mattbrejza/ukhas14-badge/board/graphics/bare.png

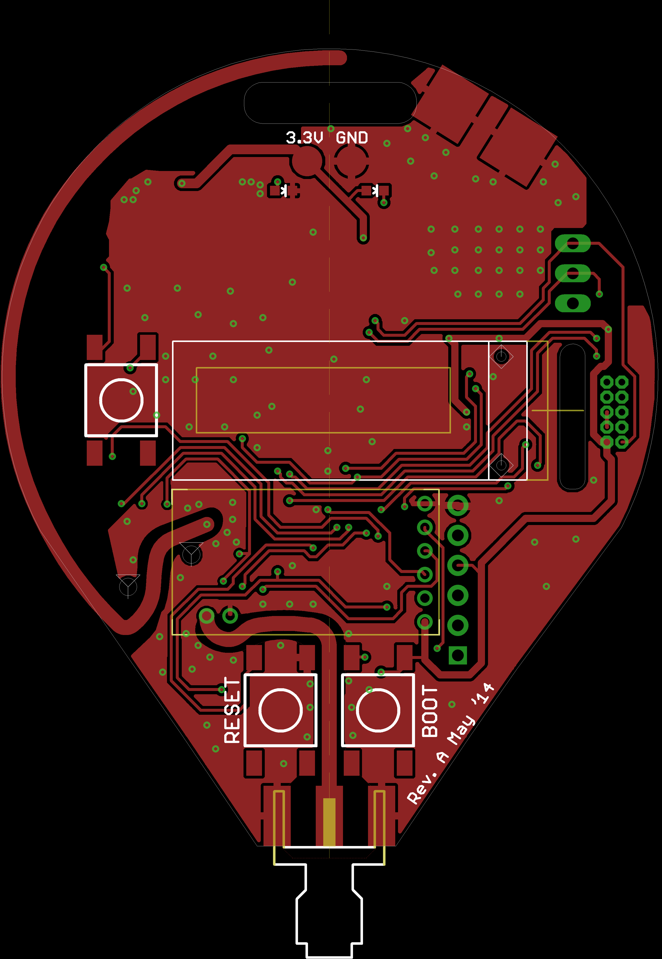
board/graphics/bare.png
