mattbrejza/ukhas14-badge/board/graphics/barepadssilk.png

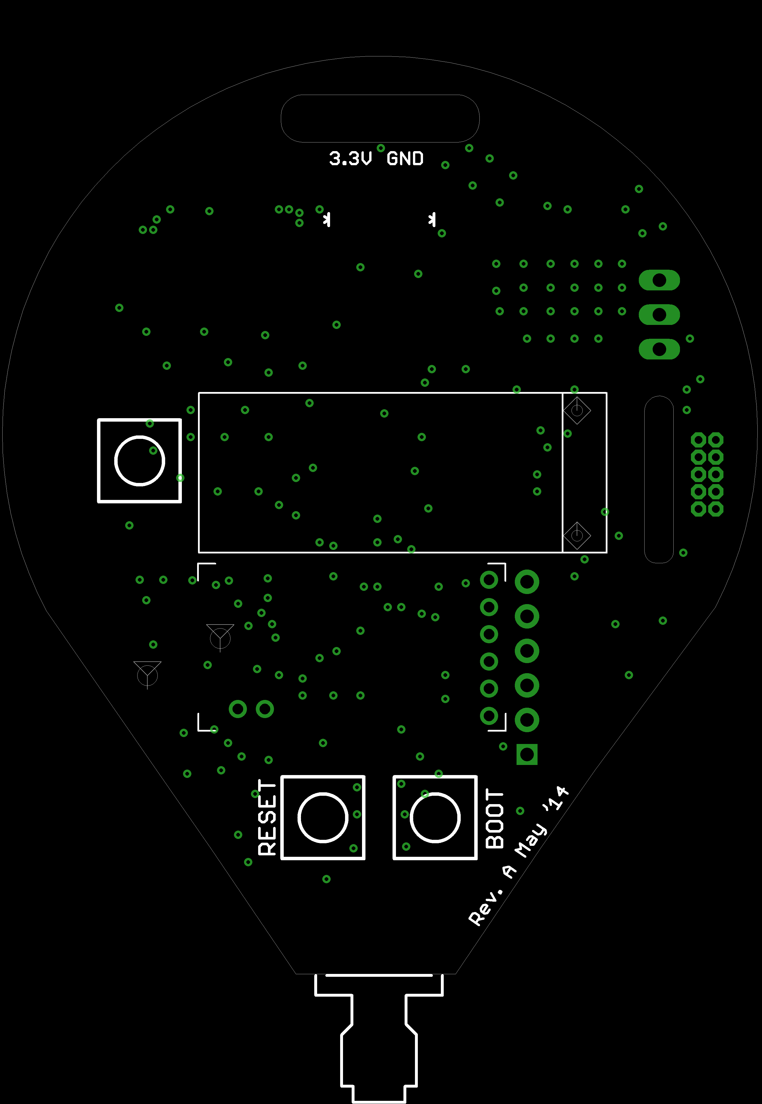
board/graphics/barepadssilk.png
