mattbrejza/ukhas14-badge/board/badge.brd

## EAGLE design board/badge.brd (2014-07-02)

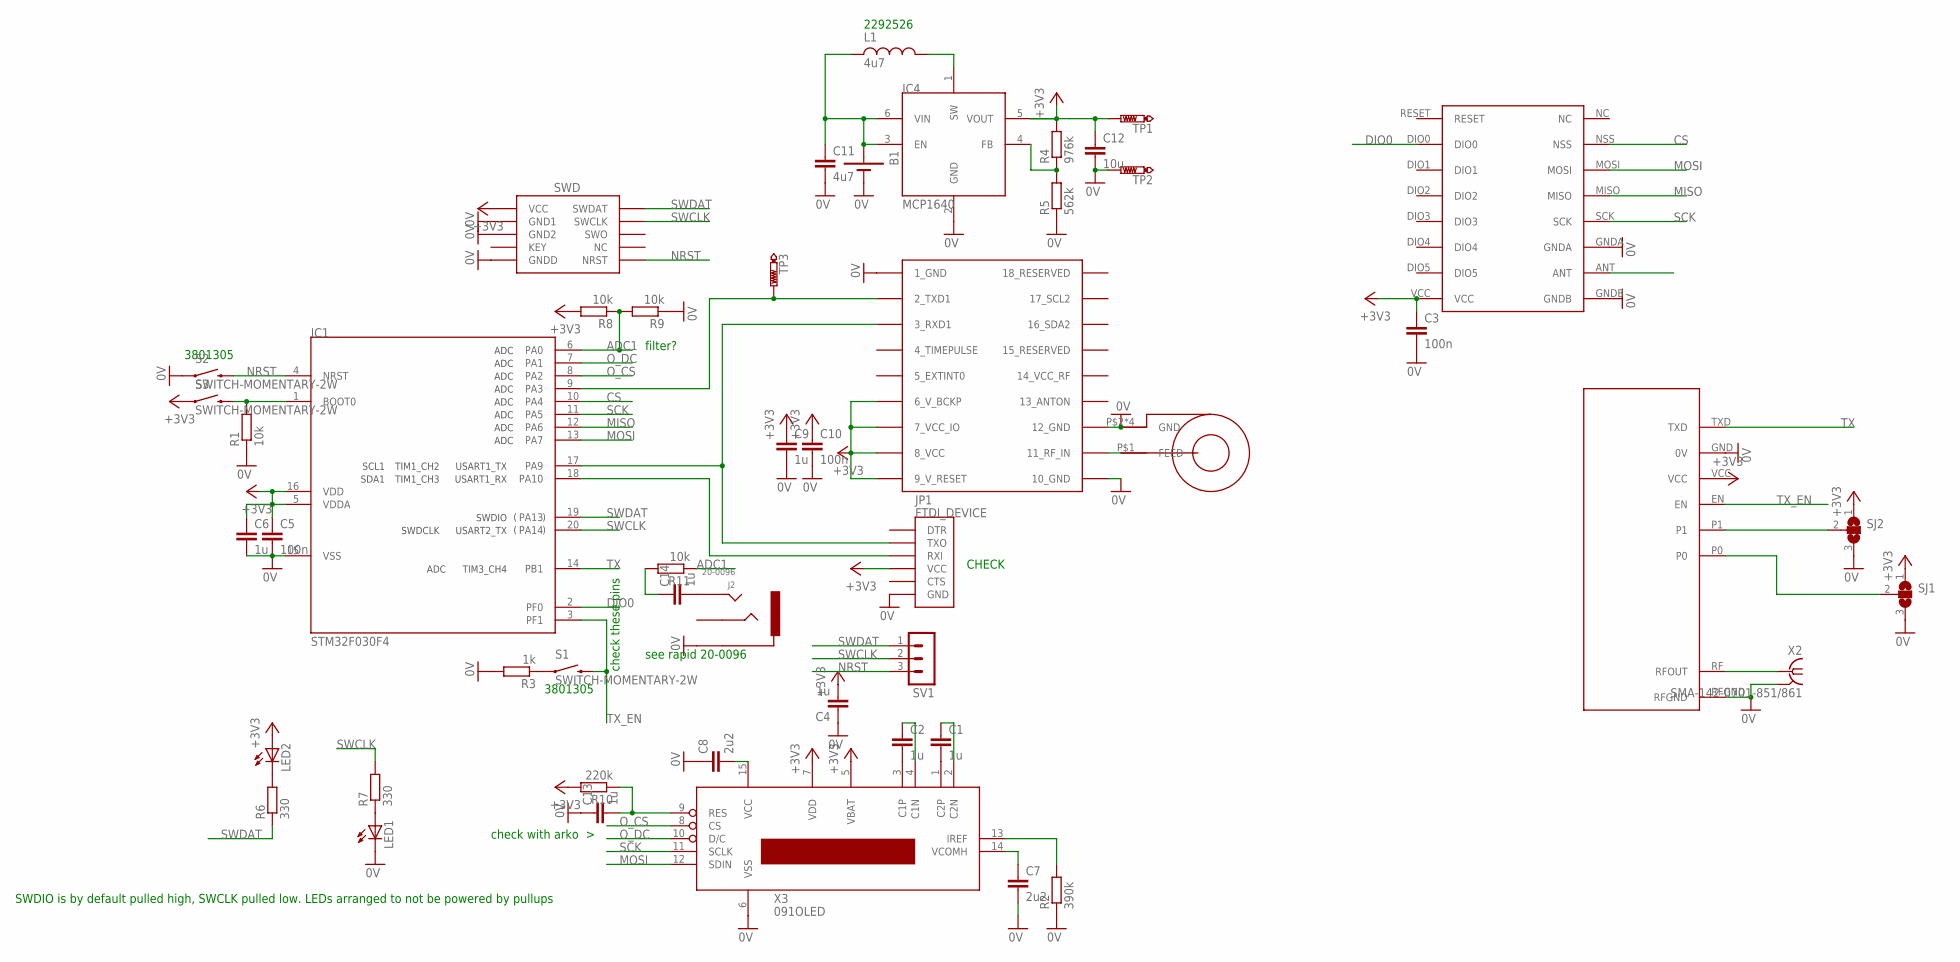
[picture p3: schematic badge.sch]

Parts:
B1: 1.5V-BATTERY-AAA-SMT-CLIPS; AAA-HOLDER-SMT-CLIPS
C1, C2, C4, C6, C9, C13, C14: 1u; C0603
C3, C5, C10: 100n; C0603
C7, C8: 2u2; C0603
C11: 4u7; C0805
C12: 10u; C0805
IC1: STM32F030F4; TSSOP20
IC2: UBLOX_MAX
IC3: RFM69HW; RFM
IC4: MCP1640; SOT23-6
J2: 20-0096; 3.5MMLOWPROFILE
J3: SWD_PTH_SHROUD
JP1: FTDI_DEVICE; FTDI_DEVICE_SIDE
L1: 4u7; INDUCTOR5X5
LED1, LED2: LED0603; LED-0603
R1, R8, R9, R11: 10k; R0603
R2: 390k; R0603
R3: 1k; R0603
R4: 976k; R0603
R5: 562k; R0603
R6, R7: 330; R0603
R10: 220k; R0603
S1, S2, S3: SWITCH-MOMENTARY-2W; TACTILE_WIDE
SJ1, SJ2: SJ2W; SJ_2
SV1: MA03-1
TP1, TP2, TP3: PTR1B2,54; B2,54
U$2: JDGA-REMQV-ANTENNA; JDGA-RIGID_COMBO_PAD
X1: RADIOMETRIX-MTX2
X2: SMA-142-0701-851/861; J502-ND-142-0701-851/861
X3: 091OLED; 0.91OLEDCON

Connections:
0V: B1.-1 (-), B1.-2 (-), C3.2, C4.1, C5.2, C6.2, C7.2, C8.1, C9.2, C10.2, C11.2, C12.2, C13.1, IC1.15 (VSS), IC2.1_GND, IC2.10_GND, IC2.12_GND, IC3.GNDA, IC3.GNDB, IC4.2 (GND), J2.2_1 (2), J2.2_2 (2), J3.3 (GND1), J3.5 (GND2), J3.9 (GNDD), JP1.P$6 (GND), LED1.C, R1.1, R2.1, R3.2, R5.1, R9.1, S2.A2 (1), SJ1.3, SJ2.3, TP2.TP, U$2.P$2 (GND), U$2.P$3 (GND), U$2.P$4 (GND), U$2.P$5 (GND), X1.GND (0V), X1.RFGND, X2.G@1 (2), X2.G@2 (2), X2.G@3 (2), X2.G@4 (2), X3.6 (VSS)
+3V3: C3.1, C4.2, C5.1, C6.1, C9.1, C10.1, C12.1, IC1.5 (VDDA), IC1.16 (VDD), IC2.6_V_BCKP, IC2.7_VCC_IO, IC2.8_VCC, IC2.9_V_RESET, IC3.VCC, IC4.5 (VOUT), J3.1 (VCC), JP1.P$4 (VCC), LED2.A, R4.2, R8.2, R10.2, S3.A2 (1), SJ1.1, SJ2.1, TP1.TP, X1.VCC, X3.5 (VBAT), X3.7 (VDD)
ADC1: IC1.6 (PA0), R8.1, R9.2, R11.1
CS: IC1.10 (PA4), IC3.NSS
DIO0: IC1.2 (PF0), IC3.DIO0
MISO: IC1.12 (PA6), IC3.MISO
MOSI: IC1.13 (PA7), IC3.MOSI, X3.12 (SDIN)
unnamed: IC2.11_RF_IN, U$2.P$1 (FEED)
unnamed: IC1.9 (PA3), IC2.2_TXD1, TP3.TP
unnamed: LED2.C, R6.2
unnamed: X1.RF (RFOUT), X2.1
unnamed: R2.2, X3.13 (IREF)
unnamed: IC1.1 (BOOT0), R1.2, S3.B2 (2)
unnamed: IC1.17 (PA9), IC2.3_RXD1, JP1.P$2 (TXO)
unnamed: IC1.18 (PA10), JP1.P$3 (RXI)
unnamed: C2.2, X3.3 (C1P)
unnamed: C1.2, X3.1 (C2P)
unnamed: C2.1, X3.4 (C1N)
unnamed: C1.1, X3.2 (C2N)
unnamed: IC4.4 (FB), R4.1, R5.2
unnamed: IC4.1 (SW), L1.P$2 (2)
unnamed: C7.1, X3.14 (VCOMH)
unnamed: LED1.A, R7.1
unnamed: SJ2.2, X1.P1
unnamed: R3.1, S1.A2 (1)
unnamed: SJ1.2, X1.P0
unnamed: C13.2, R10.1, X3.9 (RES)
unnamed: C14.2, J2.4_1 (4), J2.4_2 (4)
unnamed: C14.1, R11.2
NRST: IC1.4 (NRST), J3.10 (NRST), S2.B2 (2), SV1.3
O_CS: IC1.8 (PA2), X3.8 (CS)
O_DC: IC1.7 (PA1), X3.10 (D/C)
SCK: IC1.11 (PA5), IC3.SCK, X3.11 (SCLK)
SWCLK: IC1.20 (PA14), J3.4 (SWCLK), R7.2, SV1.2
SWDAT: IC1.19 (PA13), J3.2 (SWDAT), R6.1, SV1.1
TX: IC1.14 (PB1), X1.TXD
TX_EN: IC1.3 (PF1), S1.B2 (2), X1.EN
VCC: C8.2, X3.15 (VCC)
VIN: B1.+1 (+), B1.+2 (+), C11.1, IC4.3 (EN), IC4.6 (VIN), L1.P$1 (1)

Notes on the sheet:
see rapid 20-0096
check with arko >
check these pins
SWDIO is by default pulled high, SWCLK pulled low. LEDs arranged to not be powered by pullups
filter?
2292526
3801305
CHECK

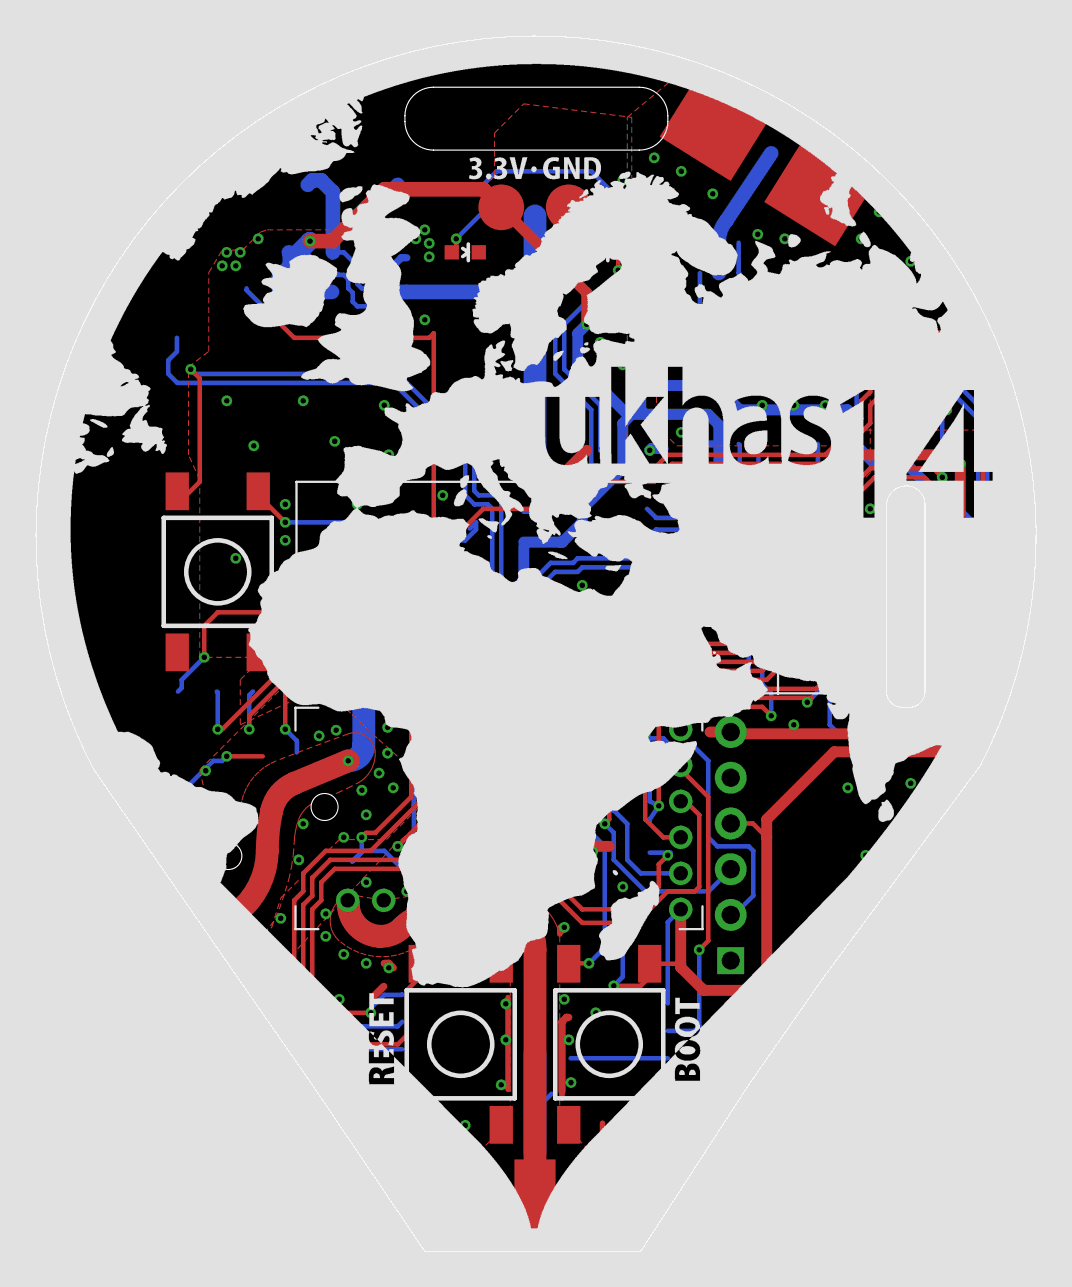
[picture p4: board badge.brd from above]

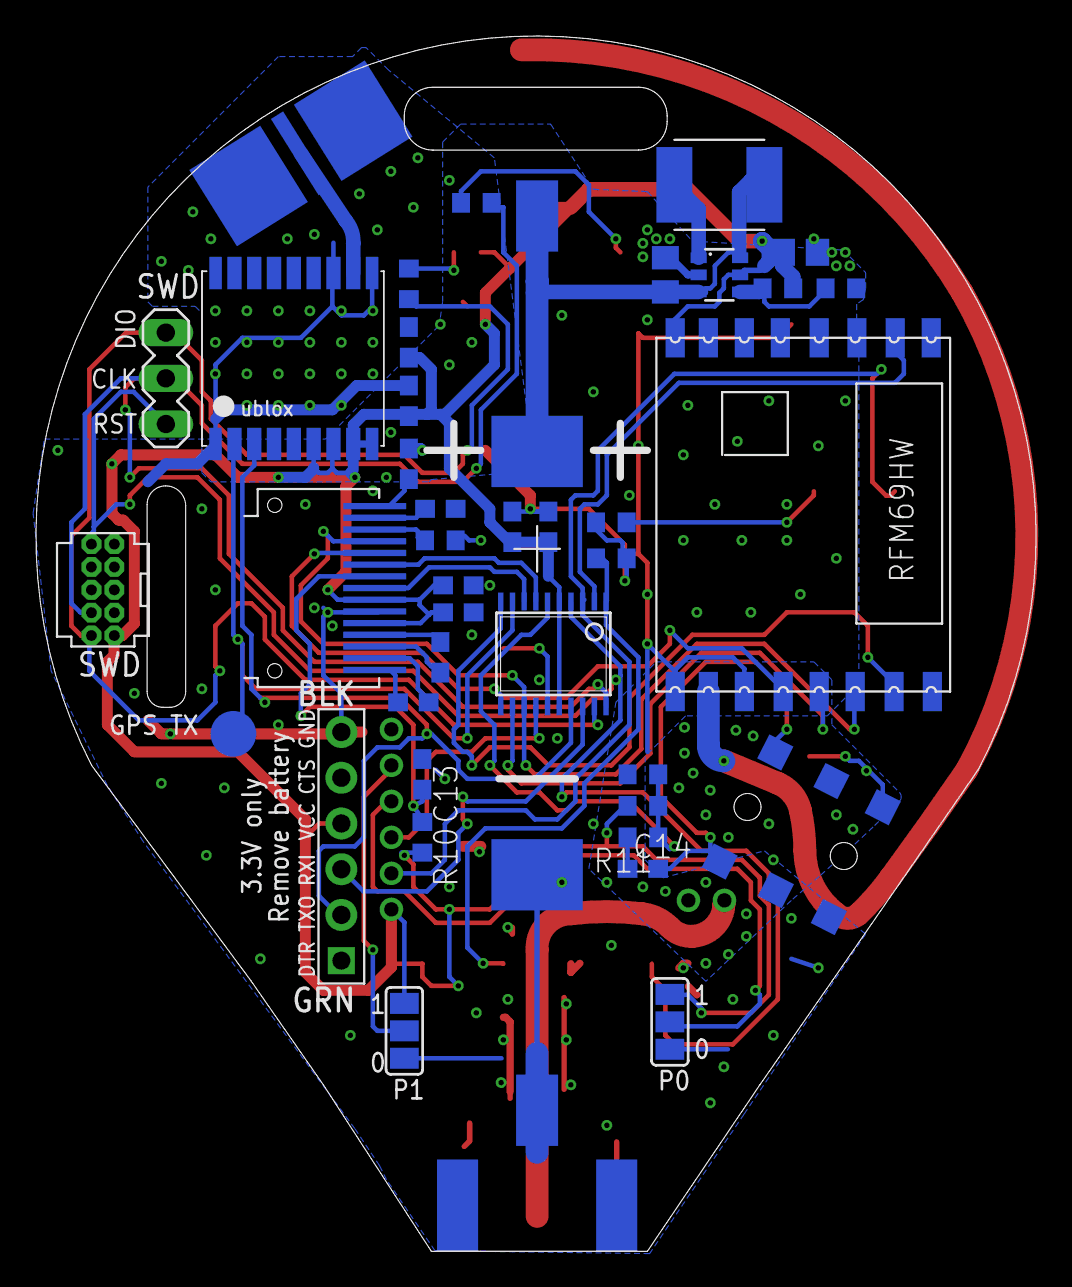
[picture p5: board badge.brd from below]

Board: 2 copper layers, 55.6 x 67.5 mm, 50 parts (40 on the bottom side), 39 nets.

Other parts of the board:
U$1: 0.91OLEDPANEL
