mattbrejza/ukhas14-badge/board/badge2012.brd

## EAGLE design board/badge2012.brd (2014-05-22)

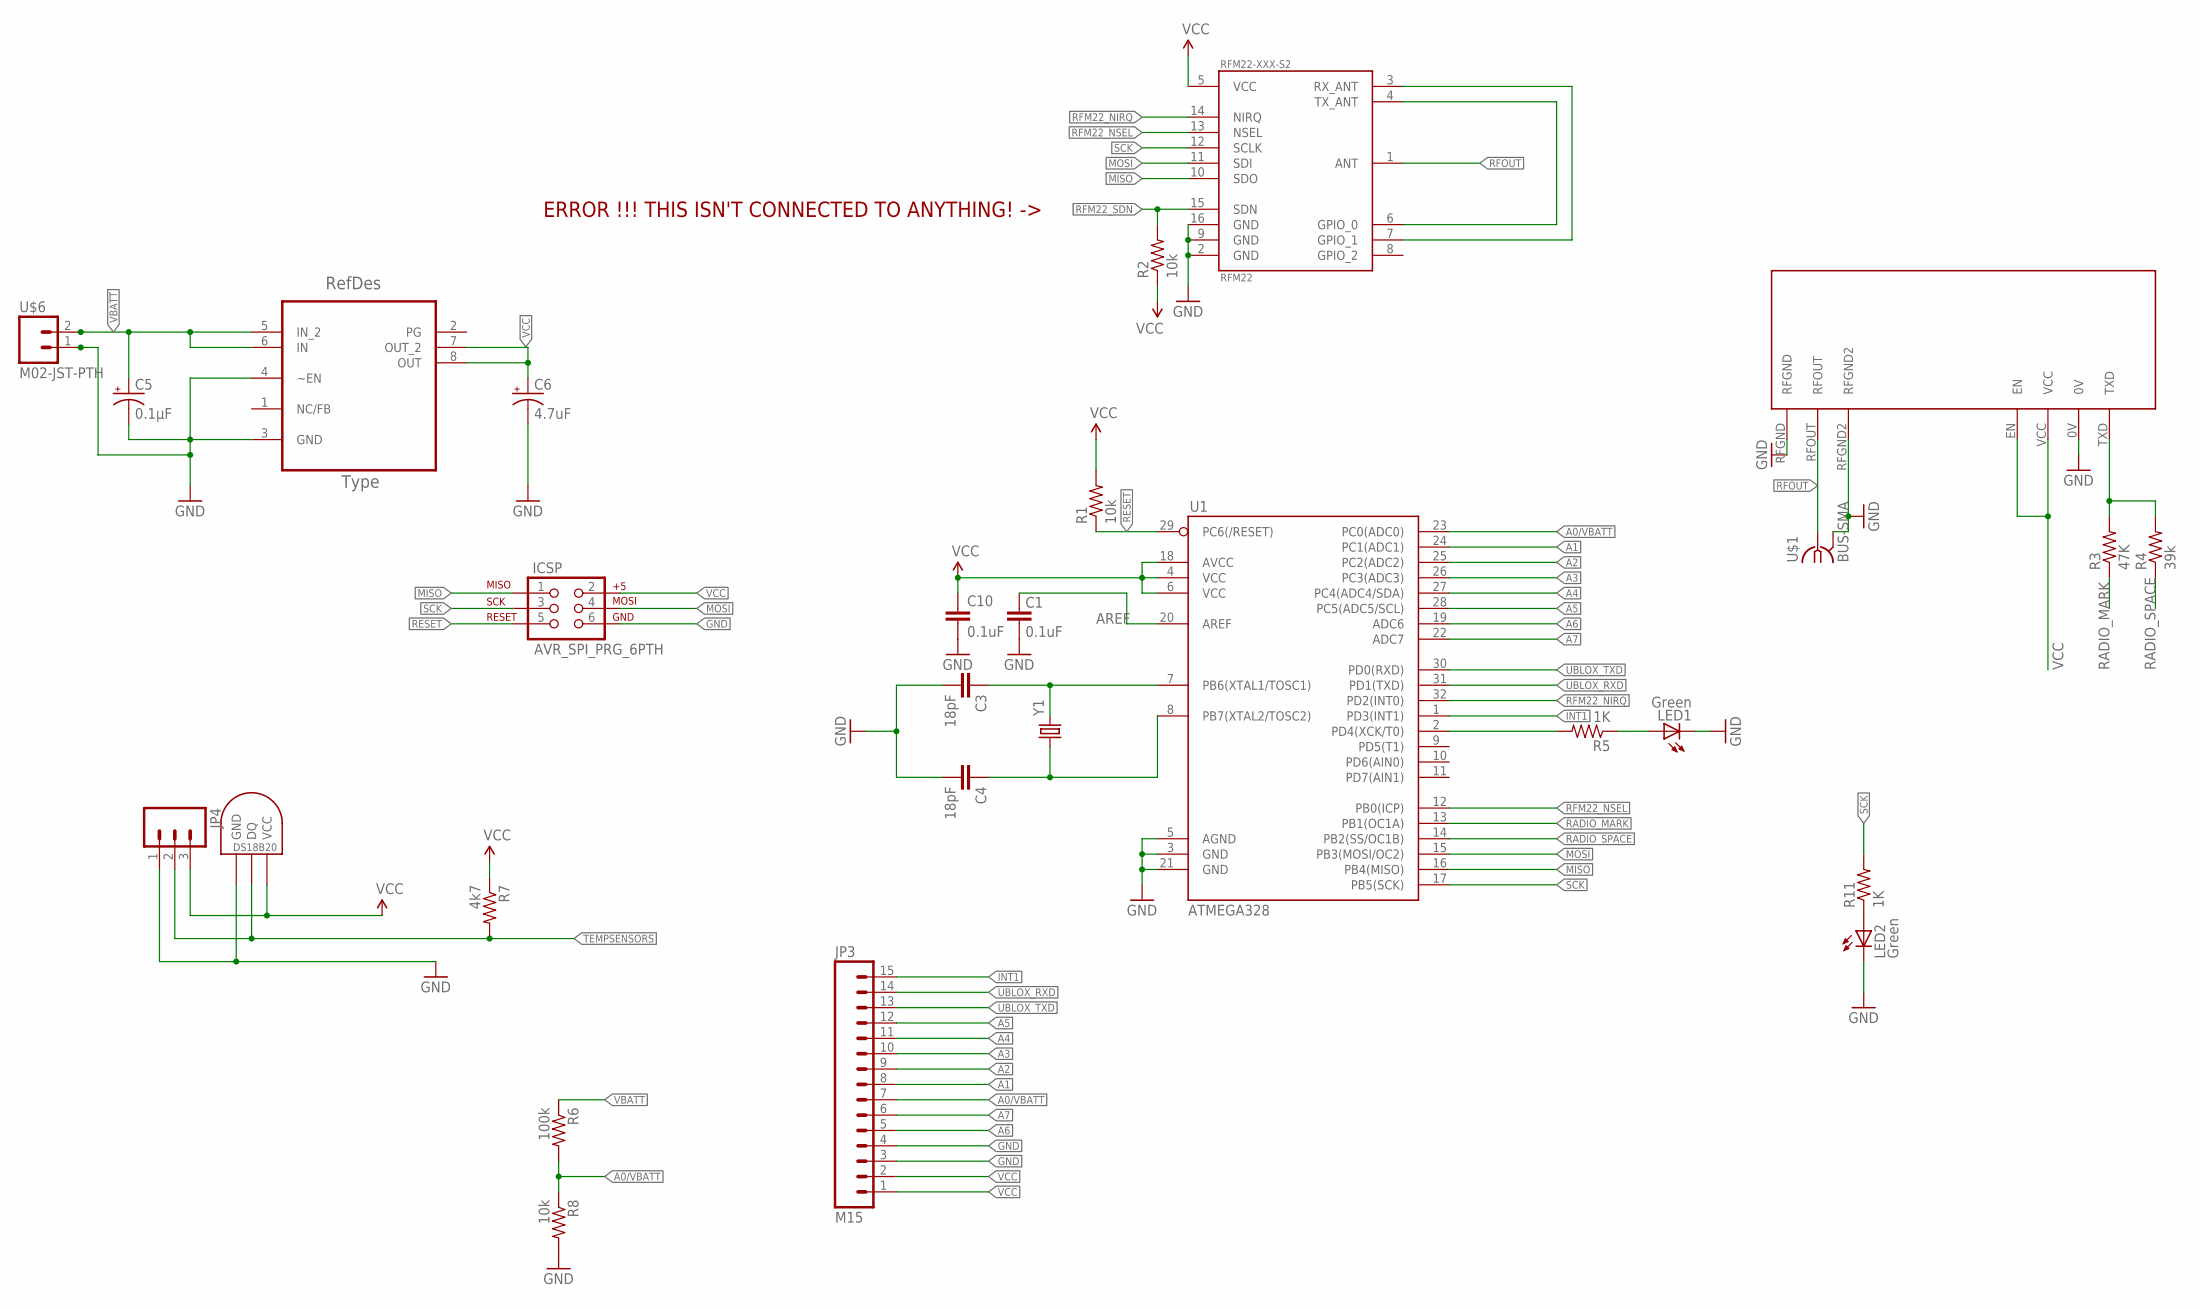
[picture p6: schematic badge2012.sch]

Parts:
C1, C10: 0.1uF; 0603-CAP
C3, C4: 18pF; 0603-CAP
C5: 0.1µF; EIA3216-KIT
C6: 4.7uF; EIA3216-KIT
ICSP: AVR_SPI_PRG_6PTH; 2X3
JP3: M15; 1X15
JP4: M03PTH; 1X03
LED1, LED2: Green; LED-0603
NTX2TEMP: DS1821; DS18B20_SOIC
R1, R2, R8: 10k; 0603-RES
R3: 47K; 0603-RES
R4: 39k; 0603-RES
R5, R11: 1K; 0603-RES
R6: 100k; 0603-RES
R7: 4k7; 0603-RES
RFM22-XXX-S2: RFM22; RFM22-XXX-S2
U1: ATMEGA328; TQFP32-08
U2: TPS76633D; SOIC127P600X175-8N
U$1: BUS-SMA
U$4: NTX2
U$6: M02-JST-PTH
Y1: CRYSTALSMD; HC49UP

Connections:
A0/VBATT: JP3.7, R6.2, R8.1, U1.23 (PC0(ADC0))
A1: JP3.8, U1.24 (PC1(ADC1))
A2: JP3.9, U1.25 (PC2(ADC2))
A3: JP3.10, U1.26 (PC3(ADC3))
A4: JP3.11, U1.27 (PC4(ADC4/SDA))
A5: JP3.12, U1.28 (PC5(ADC5/SCL))
A6: JP3.5, U1.19 (ADC6)
A7: JP3.6, U1.22 (ADC7)
AREF: C1.2, U1.20 (AREF)
GND: C1.1, C3.2, C4.2, C5.C (-), C6.C (-), C10.2, ICSP.6, JP3.3, JP3.4, JP4.1, LED1.C, LED2.C, NTX2TEMP.GND, R8.2, RFM22-XXX-S2.2 (GND), RFM22-XXX-S2.9 (GND), RFM22-XXX-S2.16 (GND), U1.3 (GND), U1.5 (AGND), U1.21 (GND), U2.3 (GND), U2.4 (~EN), U$1.2 (GND), U$1.3 (GND), U$1.4 (GND), U$1.5 (GND), U$4.0V, U$4.RFGND, U$4.RFGND2, U$6.1
INT1: JP3.15, U1.1 (PD3(INT1))
MISO: ICSP.1, RFM22-XXX-S2.10 (SDO), U1.16 (PB4(MISO))
MOSI: ICSP.4, RFM22-XXX-S2.11 (SDI), U1.15 (PB3(MOSI/OC2))
unnamed: R5.2, U1.2 (PD4(XCK/T0))
unnamed: R3.2, R4.2, U$4.TXD
unnamed: LED1.A, R5.1
unnamed: RFM22-XXX-S2.3 (RX_ANT), RFM22-XXX-S2.7 (GPIO_1)
unnamed: RFM22-XXX-S2.4 (TX_ANT), RFM22-XXX-S2.6 (GPIO_0)
unnamed: LED2.A, R11.1
unnamed: C3.1, U1.7 (PB6(XTAL1/TOSC1)), Y1.2
unnamed: C4.1, U1.8 (PB7(XTAL2/TOSC2)), Y1.1
RADIO_MARK: R3.1, U1.13 (PB1(OC1A))
RADIO_SPACE: R4.1, U1.14 (PB2(SS/OC1B))
RESET: ICSP.5, R1.1, U1.29 (PC6(/RESET))
RFM22_NIRQ: RFM22-XXX-S2.14 (NIRQ), U1.32 (PD2(INT0))
RFM22_NSEL: RFM22-XXX-S2.13 (NSEL), U1.12 (PB0(ICP))
RFM22_SDN: R2.2, RFM22-XXX-S2.15 (SDN)
RFOUT: RFM22-XXX-S2.1 (ANT), U$1.1, U$4.RFOUT
SCK: ICSP.3, R11.2, RFM22-XXX-S2.12 (SCLK), U1.17 (PB5(SCK))
TEMPSENSORS: JP4.2, NTX2TEMP.DQ, R7.2
UBLOX_RXD: JP3.14, U1.31 (PD1(TXD))
UBLOX_TXD: JP3.13, U1.30 (PD0(RXD))
VBATT: C5.A (+), R6.1, U2.5 (IN_2), U2.6 (IN), U$6.2
VCC: C6.A (+), C10.1, ICSP.2, JP3.1, JP3.2, JP4.3, NTX2TEMP.VCC, R1.2, R2.1, R7.1, RFM22-XXX-S2.5 (VCC), U1.4 (VCC), U1.6 (VCC), U1.18 (AVCC), U2.7 (OUT_2), U2.8 (OUT), U$4.EN, U$4.VCC

Notes on the sheet:
ERROR !!! THIS ISN'T CONNECTED TO ANYTHING! ->

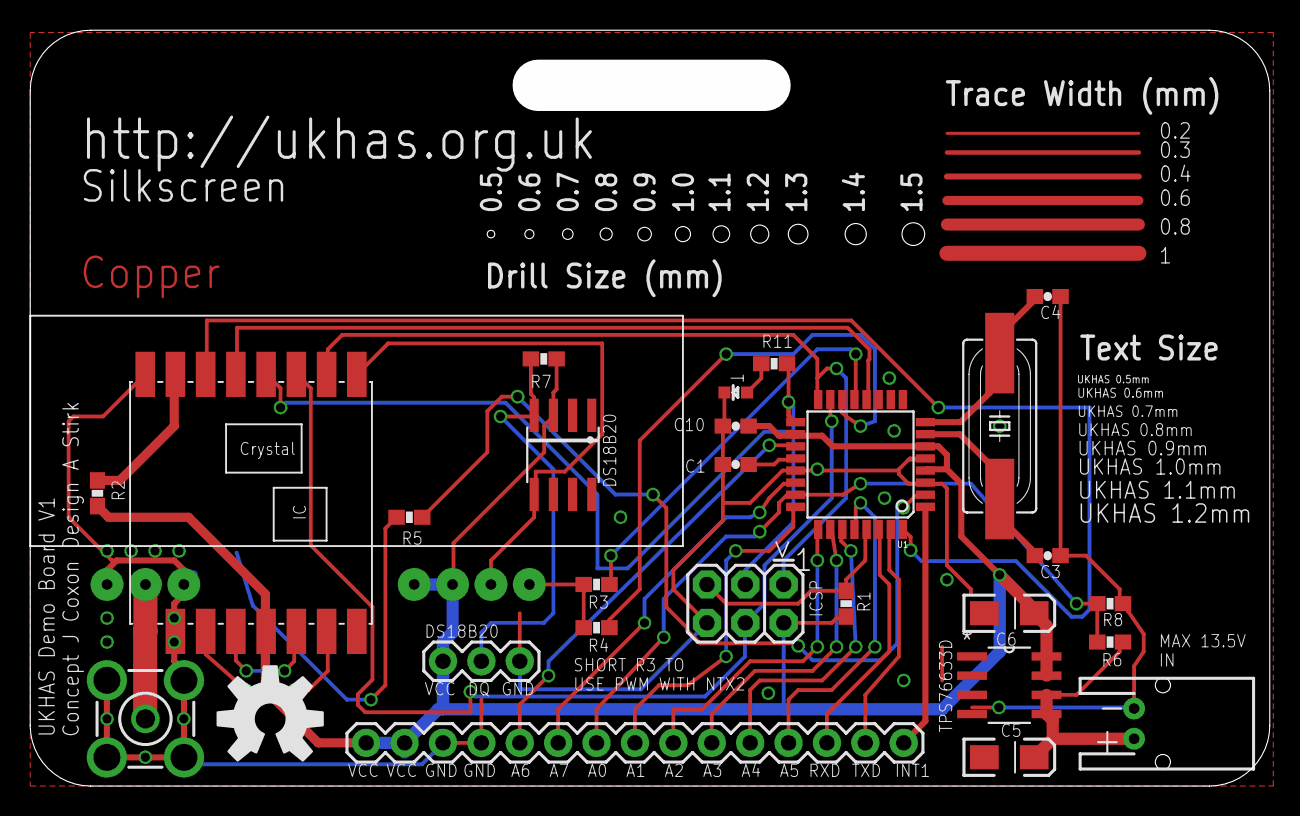
[picture p7: board badge2012.brd from above]

Board: 2 copper layers, 82.0 x 50.0 mm, 29 parts (1 on the bottom side), 34 nets.

Other parts of the board:
U$2: OSHW-LOGO-L
