mattbrejza/ukhas14-badge/firmware/src/badge.h

/**
* This file is part of the UKHAS 2014 Badge project
*
* Jon Sowman 2014
* <jon@jonsowman.com>
*/

#ifndef __UKHAS_BADGE_H__
#define __UKHAS_BADGE_H__

/* We need to include at least once locm3 unit for type definitions */
#include <libopencm3/stm32/rcc.h>

void _delay_ms(const uint32_t delay);

#endif /* __UKHAS_BADGE_H__ */
