mattbrejza/ukhas14-badge/firmware/src-dsp/dsp-test.c

#include <stdio.h>
#include <stdlib.h>
#include <inttypes.h>
#include <stdint.h>
#include <stdbool.h>
#include "demodulator.h"

#include <stdlib.h>

void test(fir_state_t in)
{
	in.delay_line = 4;
}

int main(void) {
	puts("!!!Hello World!!!"); /* prints !!!Hello World!!! */

	fir_state_t fsgg;
	fsgg.delay_line = 3;
	printf("%i",fsgg.delay_line);
	test(fsgg);
	printf("%i",fsgg.delay_line);

int tyty;
	int32_t input[] = { 100, 100, 100, 100, 100, 100, 100, 100, 100, 100, 100, 100, 100, 100,
			-100, -100, -100, -100, -100, -100, -100, -100, -100, -100, -100, -100, -100, -100,
			100, 100, 100, 100, 100, 100, 100, 100, 100, 100, 100, 100, 100, 100,
			-100, -100, -100, -100, -100, -100, -100, -100, -100, -100, -100, -100, -100, -100,
			100, 100, 100, 100, 100, 100, 100, 100, 100, 100, 100, 100, 100, 100,
			-100, -100, -100, -100, -100, -100, -100, -100, -100, -100, -100, -100, -100, -100,
			100, 100, 100, 100, 100, 100, 100, 100, 100, 100, 100, 100, 100, 100,
			-100, -100, -100, -100, -100, -100, -100, -100, -100, -100, -100, -100, -100, -100,
			100, 100, 100, 100, 100, 100, 100, 100, 100, 100, 100, 100, 100, 100,
			-100, -100, -100, -100, -100, -100, -100, -100, -100, -100, -100, -100, -100, -100,
			100, 100, 100, 100, 100, 100, 100, 100, 100, 100, 100, 100, 100, 100,
			-100, -100, -100, -100, -100, -100, -100, -100, -100, -100, -100, -100, -100, -100,
			100, 100, 100, 100, 100, 100, 100, 100, 100, 100, 100, 100, 100, 100,
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
5000, 65000, 65000, 65000, 65000, 65000, 65000, 65000, 65000, 65000, 65000, 65000, 65000, 65000, 65000, 65000, 65000, 65000, 65000, 65000, 65000, 65000, 65000, 65000, 65000, 65000, 65000, 65000, 65000, 65000, 65000, 65000, 65000, 65000, 65000, 65000, 65000, 65000, 65000, 65000, 65000, 65000, 65000, 65000, 65000, 65000, 65000, 65000, 65000, 65000, 65000, 65000, 65000, 65000, 65000, 65000, 65000, 65000, 65000, 65000, 65000, 65000, 65000, 65000, 65000, 65000, 65000, 65000, 65000, 65000, 65000, 65000, 65000, 65000, 0, 13, 26, 38, 50, 61, 70, 79, 86, 92, 96, 99, 100, 99, 97, 93, 87, 80, 72, 62, 52, 40, 28, 15, 2, -11, -24, -36, -48, -59, -69, -78, -85, -91, -96, -99, -100, -100, -97, -94, -88, -82, -73, -64, -53, -42, -30, -17, -4, 9, 22, 34, 46, 57, 67, 76, 84, 90, 95, 98, 100, 100, 98, 94, 89, 83, 75, 66, 55, 44, 32, 19, 6, -7, -19, -32, -44, -55, -66, -75, -83, -89, -94, -98, -100, -100, -98, -95, -90, -84, -76, -67, -57, -46, -34, -21, -9, 4, 17, 30, 42};
	int32_t ee[] = {65000, 65000, 65000, 65000, 65000, 65000, 65000, 65000, 65000, 65000, 65000, 65000, 65000, 65000, 65000, 65000, 65000, 65000, 65000, 65000, 65000, 65000, 65000, 65000, 65000, 65000, 65000, 65000, 65000, 65000, 65000, 65000, 65000, 65000, 65000, 65000, 65000, 65000, 65000, 65000, 65000, 65000, 65000, 65000, 65000, 65000, 65000, 65000, 65000, 65000, 65000, 65000, 65000, 65000, 65000, 65000, 65000, 65000, 65000, 65000, 65000, 65000, 65000, 65000, 65000, 65000, 65000, 65000, 65000, 65000, 65000, 65000, 65000, 65000, 65000, 65000, 65000, 65000, 65000, 65000, 65000, 65000, 65000, 65000, 65000, 65000, 65000, 65000, 65000, 65000, 65000, 65000, 65000, 65000, 65000, 65000, 65000, 65000, 65000, 65000, 65000, 65000, 65000, 65000, 65000, 65000, 65000, 65000, 65000, 65000, 65000, 65000, 65000, 65000, 65000, 65000, 65000, 65000, 65000, 65000, 65000, 65000, 65000, 65000, 65000, 65000, 65000, 65000, 65000, 65000, 65000, 65000, 65000, 65000, 65000, 65000, 65000, 65000, 65000, 65000, 65000, 65000, 65000, 65000, 65000, 65000, 65000, 65000, 65000, 65000, 65000, 65000, 65000, 65000, 65000, 65000, 65000, 65000, 65000, 65000, 65000, 65000, 65000, 65000, 65000, 65000, 65000, 65000, 65000, 65000, 65000, 65000, 65000, 65000, 65000, 65000, 65000, 65000, 65000, 65000, 65000, 65000, 65000, 65000, 65000, 65000, 65000, 65000, 65000, 65000, 65000, 65000, 65000, 65000, 65000, 65000, 65000, 65000, 65000, 65000, 65000, 65000, 65000, 65000, 65000, 65000, 65000, 65000, 65000, 65000, 65000, 65000,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

	//s1.delay_line_in = delay_line1;
	//s1.delay_line_out = delay_line2;
	//s1.stages = 4;
	//s1.rate = 5;
/*

	int count = cic_filter(s1, ff, output2,  600);

		int count2 =  bit_sync(s2, syncin, syncout, 3000);

		int count3 = char_sync(s3, syncout, text, count2, 7);
*/


	//l=8
	int16_t sin_lut_1k[] = {0, 707, 1000, 707, 0, -707, -1000, -707};
	int16_t cos_lut_1k[]  = {1000, 707, 0, -707, -1000, -707, 0, 707};


	//l=32
	int16_t sin_lut_750[] = {0, 556, 924, 981, 707, 195, -383, -831, -1000, -831, -383, 195, 707, 981, 924, 556, 0, -556, -924, -981, -707, -195, 383, 831, 1000, 831, 383, -195, -707, -981, -924, -556};
	int16_t cos_lut_750[] = {1000, 831, 383, -195, -707, -981, -924, -556, 0, 556, 924, 981, 707, 195, -383, -831, -1000, -831, -383, 195, 707, 981, 924, 556, 0, -556, -924, -981, -707, -195, 383, 831};



	//int16_t adc_buffer[] = {-333, -506, -436, -157, 200, 462, 488, 236, -176, -481, -440, -78, 332, 512, 354, -45, -418, -496, -228, 191, 482, 447, 104, -311, -511, -369, 18, 395, 505, 272, -143, -462, -471, -160, 260, 502, 409, 41, -357, -511, -319, 87, 435, 490, 213, -209, -488, -439, -95, 315, 511, 361, -31, -403, -503, -262, 156, 468, 466, 148, -269, -505, -399, -25, 367, 511, 309, -101, -443, -486, -201, 221, 492, 432, 81, -326, -512, -352, 46, 412, 501, 251, -169, -474, -459, -135, 281, 507, 390, 11, -376, -509, -298, 115, 450, 481, 188, -233, -496, -424, -66, 336, 512, 342, -60, -420, -498, -239, 181, 479, 453, 121, -292, -509, -381, 4, 386, 508, 287, -128, -456, -476, -175, 245, 499, 416, 52, -347, -512, -331, 73, 428, 494, 226, -194, -484, -446, -108, 304, 510, 372, -17, -395, -506, -275, 141, 462, 471, 162, -257, -502, -408, -39, 357, 511, 321, -87, -436, -490, -214, 207, 488, 440, 96, -308, -509, -408, -119, 182, 396, 501, 490, 340, 72, -221, -432, -512, -453, -262, 20, 299, 480, 493, 286, -115, -465, -447, -77, 333, 512, 358, -46, -424, -491, -211, 208, 487, 446, 140, -209, -435, -511, -465, -305, -46, 243, 451, 511, 425, 223, -51, -317, -485, -494, -320, 20, 388, 502, 217, -234, -498, -424, -73, 337, 512, 314, -103, -444, -487, -214, 176, 444, 511, 428, 251, 6, -262, -461, -507, -396, -177, 91, 341, 493, 488, 321, 23, -317, -510, -348, 97, 457, 473, 175, -239, -499, -405, -16, 379, 509, 300, -100, -425, -509, -391, -181, 59, 296, 471, 504, 370, 129, -139, -370, -5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
