mattbrejza/ukhas14-badge/(commit log)

2014-05-20 schematic mostly done
    [badge.brd, badge.sch]
2014-05-21 got bored, moved parts around
    [badge.brd, badge.sch]
2014-05-21 added mtx2 jumpers
    [badge.brd, badge.sch]
2014-05-21 Outline Placeholder
    And old boards for reference.
    [badge2012.brd, badge2012.sch, outline.brd]
2014-05-21 initial route
    [badge.brd, badge.sch]
2014-05-22 routing almost done
    [badge.brd, badge.sch]
2014-05-24 almost done
    [badge.brd, badge.sch]
2014-05-24 drc fixes
    [badge.brd]
2014-05-24 adding part numbers
    [badge.brd, badge.sch]
2014-05-25 Tidy up
    Replaced octagonal vias with round ones
    Replaced 0.381mm vias with 0.3mm
    Fixed 3 airwires
    Amended 20 Dimension to width 0
    [badge.brd]
2014-05-25 adding DC bias resistors
    [badge.brd, badge.sch]
2014-05-25 Tied Reset pin on GPS to VCC
    [badge.brd, badge.sch]
2014-05-26 Amended milling layer
    Made them dimension layer instead. Confuses the fab by 87.2% less.
    [badge.brd]
2014-06-18 LCD powers on successfully, just need to tidy up command definitions a bit
2014-06-25 Updated pin defs and startup routing for bodged rev.A board
    [lcd.c, lcd.h]
2014-06-26 started rev2
    [badge.brd, badge.sch]
2014-06-26 rev2 almost done
    [badge.brd, badge.sch]
2014-06-28 switching tx/rx on ftdi
    [badge.brd, badge.sch]
2014-06-28 some small changes
    [badge.brd]
2014-06-29 minor changes (might have fixed ftdi in this one)
    [badge.brd]
2014-06-30 pwm works
2014-07-02 Added silkscreen graphics files
2014-07-02 Top silkscreen graphic added.
    [badge.brd]
2014-08-09 needs adc stuff now
2014-08-12 dma is being shit
2014-08-15 set oscillator to max, tidied up
    [badge.c, demodulator.c, demodulator.h]
